minou65/ESP32-Softub/sch/ESP32-Softub.pdf

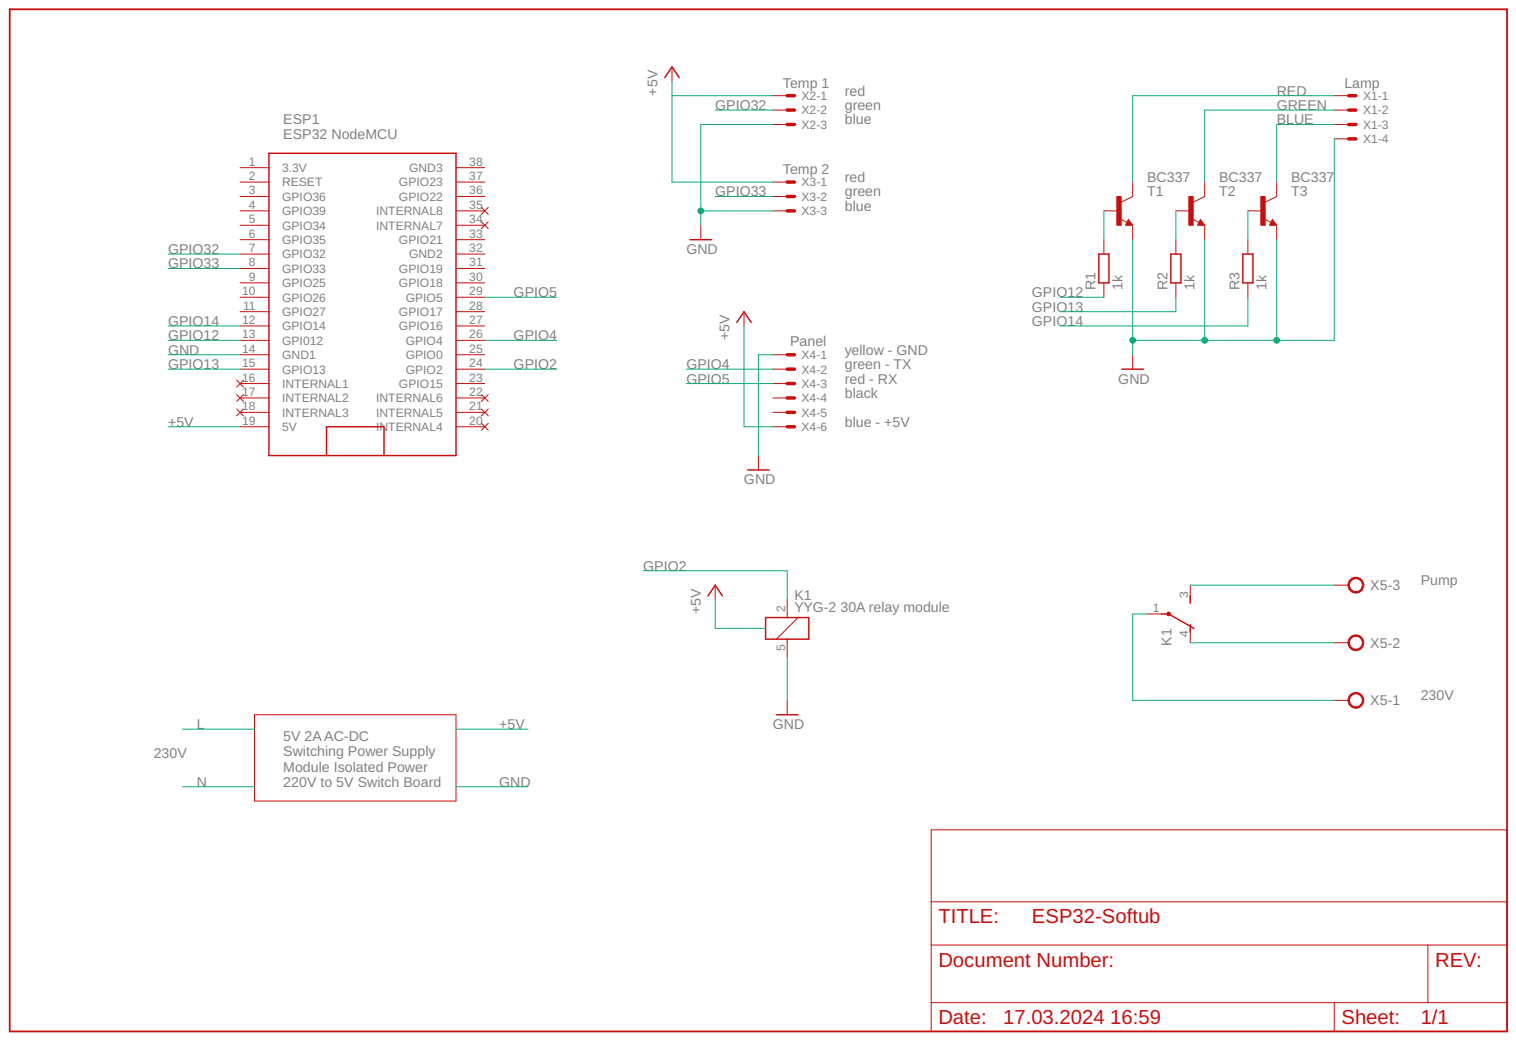
[picture p4: page 1]

YYG-2 30A relay module GND

Switching Power Supply
Module Isolated Power 220V to 5V Switch Board

Document Number: | REV:

Date: 17.03.2024 16:59 | Sheet: 1/1
