minou65/ESP32-Softub/sch/ESP32-Softub.sch

## EAGLE design sch/ESP32-Softub.sch (2024-03-17)

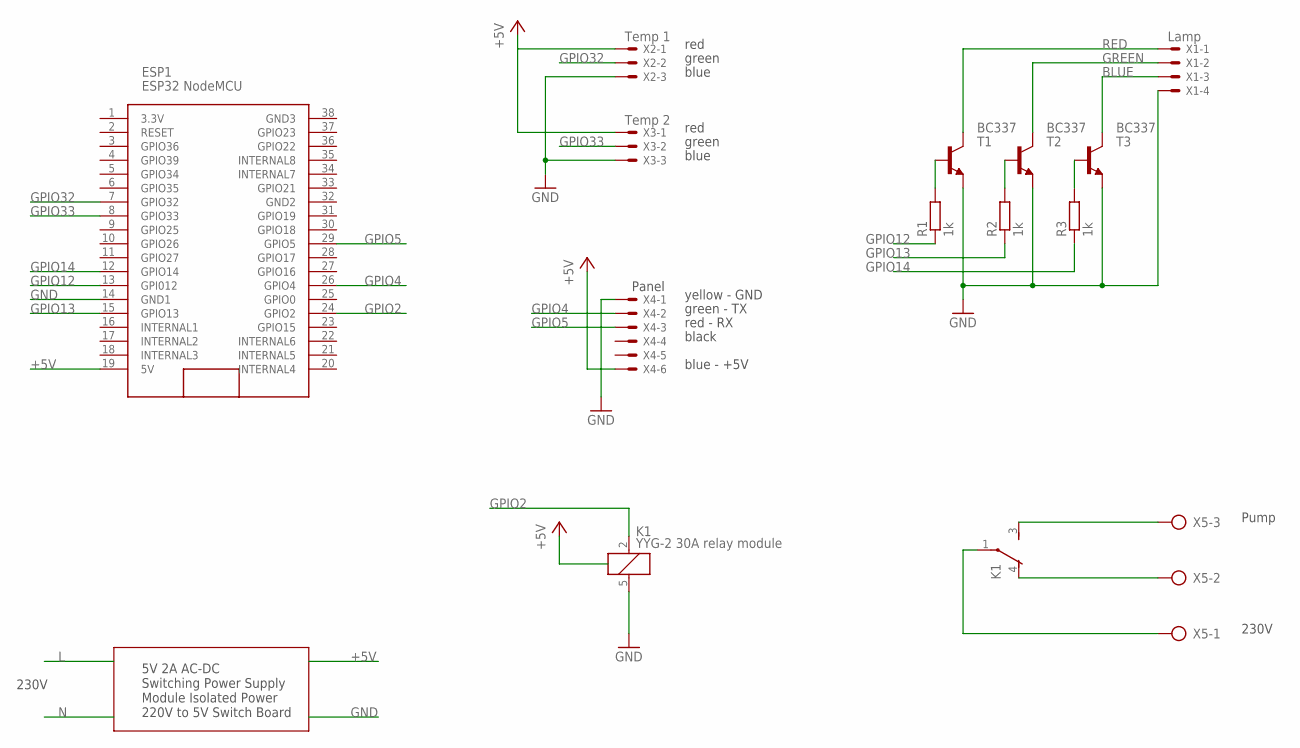
[picture p5: schematic ESP32-Softub.sch]

Parts:
ESP1: ESP32 NodeMCU; ESP32_NODEMCU
K1: YYG-2 30A relay module; AZ8
R1, R2, R3: 1k; 0309/12
T1, T2, T3: BC337; TO92
X1: Lamp; 22-23-2041
X2: Temp 1; 22-23-2031
X3: Temp 2; 22-23-2031
X4: 22-23-2061
X5: AK500/3

Connections:
+5V: ESP1.19 (5V), X2.1, X3.1, X4.6
BLUE: T3.3 (C), X1.3
GND: ESP1.14 (GND1), K1.5 (2), T1.1 (E), T2.1 (E), T3.1 (E), X1.4, X2.3, X3.3, X4.1
GPIO2: ESP1.24 (GPIO2), K1.2 (1)
GPIO4: ESP1.26 (GPIO4), X4.2
GPIO5: ESP1.29 (GPIO5), X4.3
GPIO12: ESP1.13 (GPI012), R1.1
GPIO13: ESP1.15 (GPIO13), R2.1
GPIO14: ESP1.12 (GPIO14), R3.1
GPIO32: ESP1.7 (GPIO32), X2.2
GPIO33: ESP1.8 (GPIO33), X3.2
GREEN: T2.3 (C), X1.2
unnamed: R1.2, T1.2 (B)
unnamed: R2.2, T2.2 (B)
unnamed: R3.2, T3.2 (B)
unnamed: K1.1, X5.1
unnamed: K1.3 (S), X5.3
unnamed: K1.4 (O), X5.2
RED: T1.3 (C), X1.1

Notes on the sheet:
red
blue
green
Panel
yellow - GND
green - TX
red - RX
black
blue - +5V
230V
Pump
5V 2A AC-DC Switching Power Supply Module Isolated Power 220V to 5V Switch Board
