minou65/ESP32-Softub/src/ntp.cpp

// 
// 
// 

#include "ntp.h"
#include "neotimer.h"


#define NTPUpdatePeriode 43200000 // 12h

String gNTPServer = "ntp.metas.ch"; // "pool.ntp.org";
String gTimeZone = "CET-1CEST,M3.5.0,M10.5.0/3";
int32_t gTimeOffset_sec = 0;

Neotimer NTPTimer(NTPUpdatePeriode);
ESP32Time rtc;

bool NTPSync = true;

void NTPInit() {
    Serial.println(F("ntp initializing..."));

    // https://github.com/nayarsystems/posix_tz_db/blob/master/zones.csv
    configTzTime(gTimeZone.c_str(), gNTPServer.c_str());
    NTPSync = true;

    Serial.println(F("OK"));
}

void NTPloop() {
    if (NTPTimer.repeat() || NTPSync) {

        struct tm timeinfo;
        if (getLocalTime(&timeinfo)) {
            //rtc.setTimeStruct(timeinfo);
            NTPSync = false;
            Serial.println(F("NTP time successfull set"));
            char s[51];
            strftime(s, 50, "%A, %B %d %Y %H:%M:%S", &timeinfo);
            Serial.println(s);
        }
    }
}
